kingofl337/afterglow_pico/pcb_v1.36c/render/Render.png

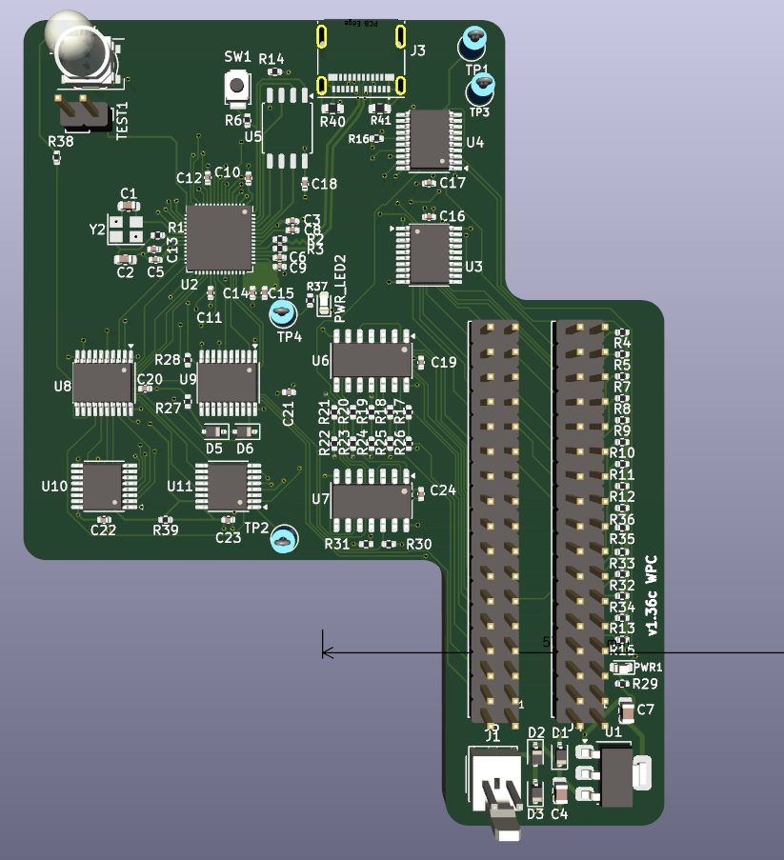
pcb_v1.36c/render/Render.png
