kingofl337/afterglow_pico/pcb_v1.36c/Afterglow Pico 1.36c.kicad_pcb

## KiCad design pcb_v1.36c/Afterglow Pico 1.36c.kicad_pcb (2025-01-01)

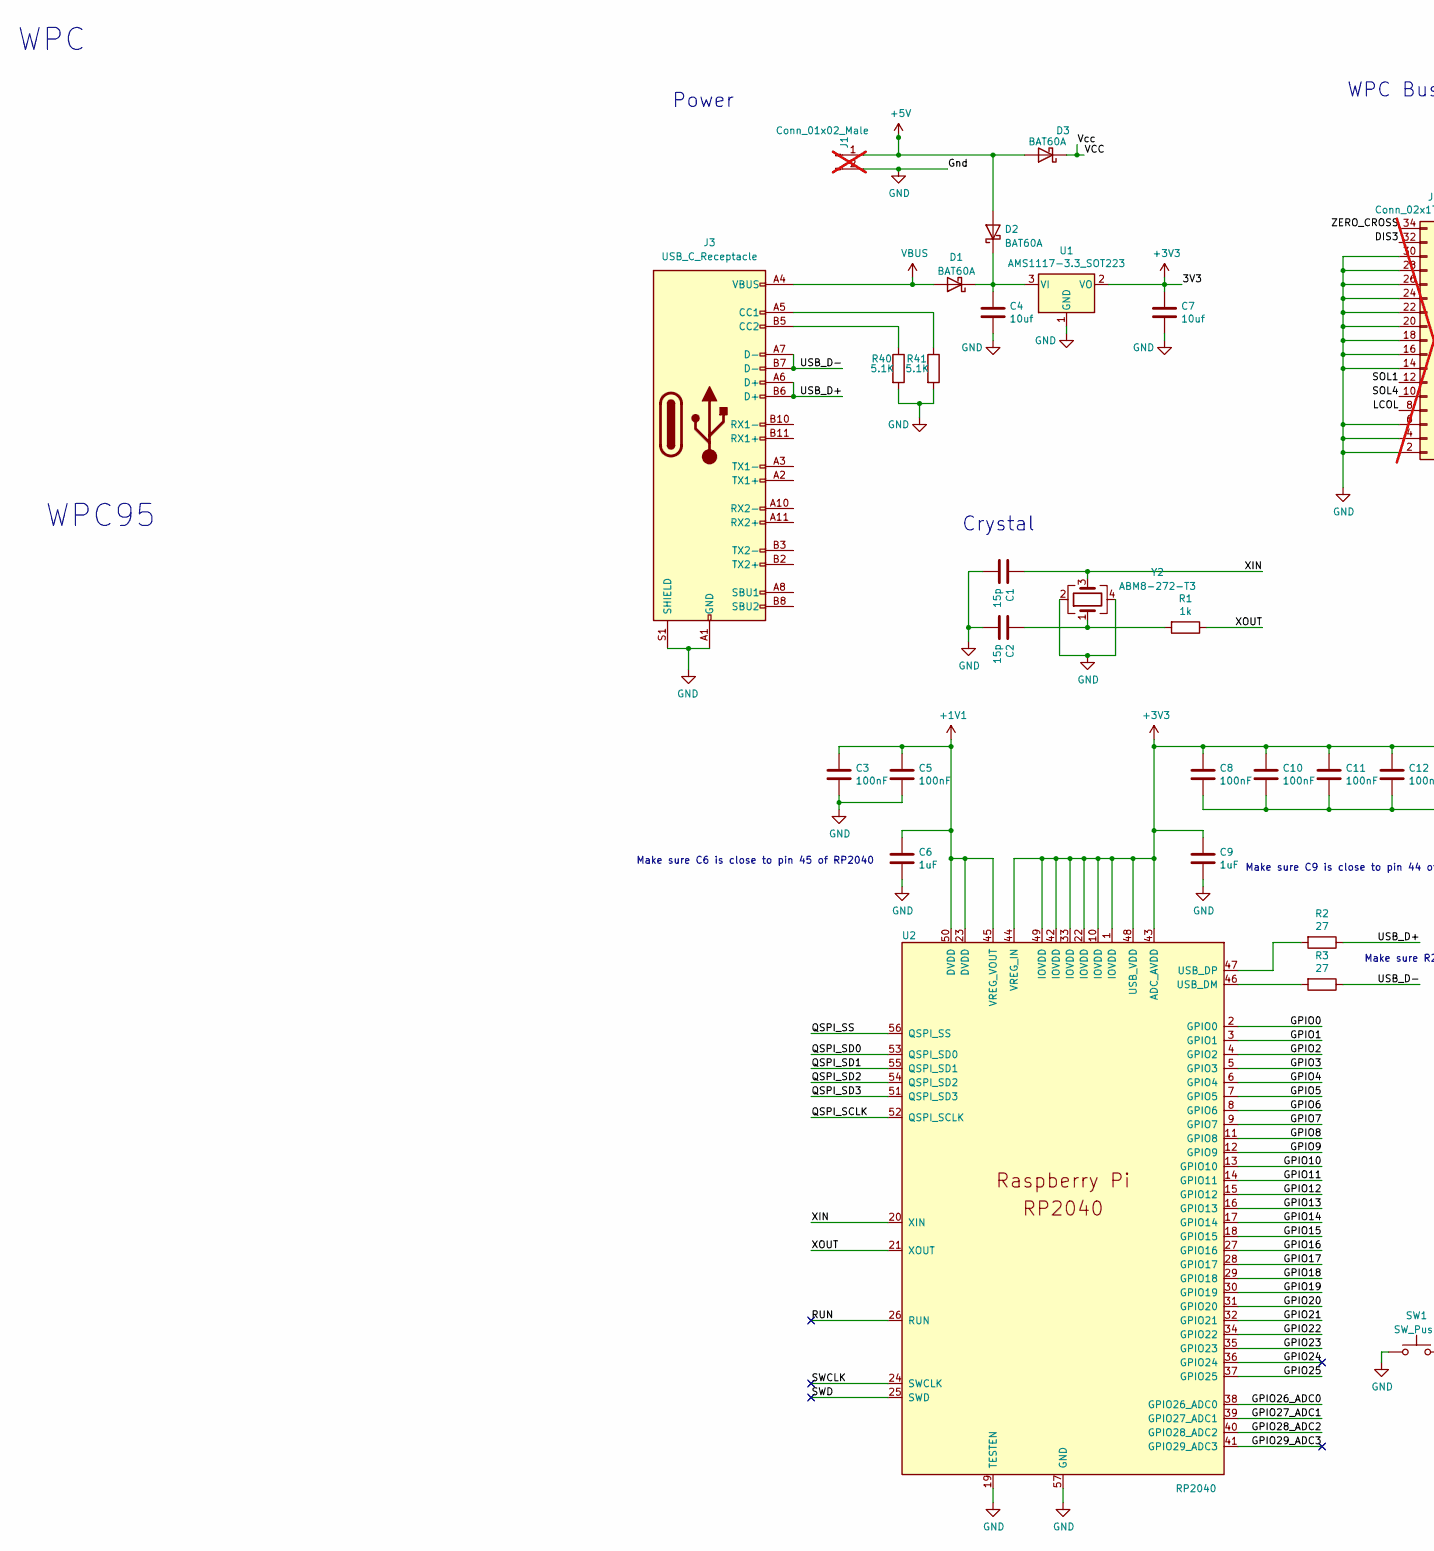
[picture p2: schematic Afterglow Pico 1.36c.kicad_sch, Afterglow Pico, part in row 1, column 1]

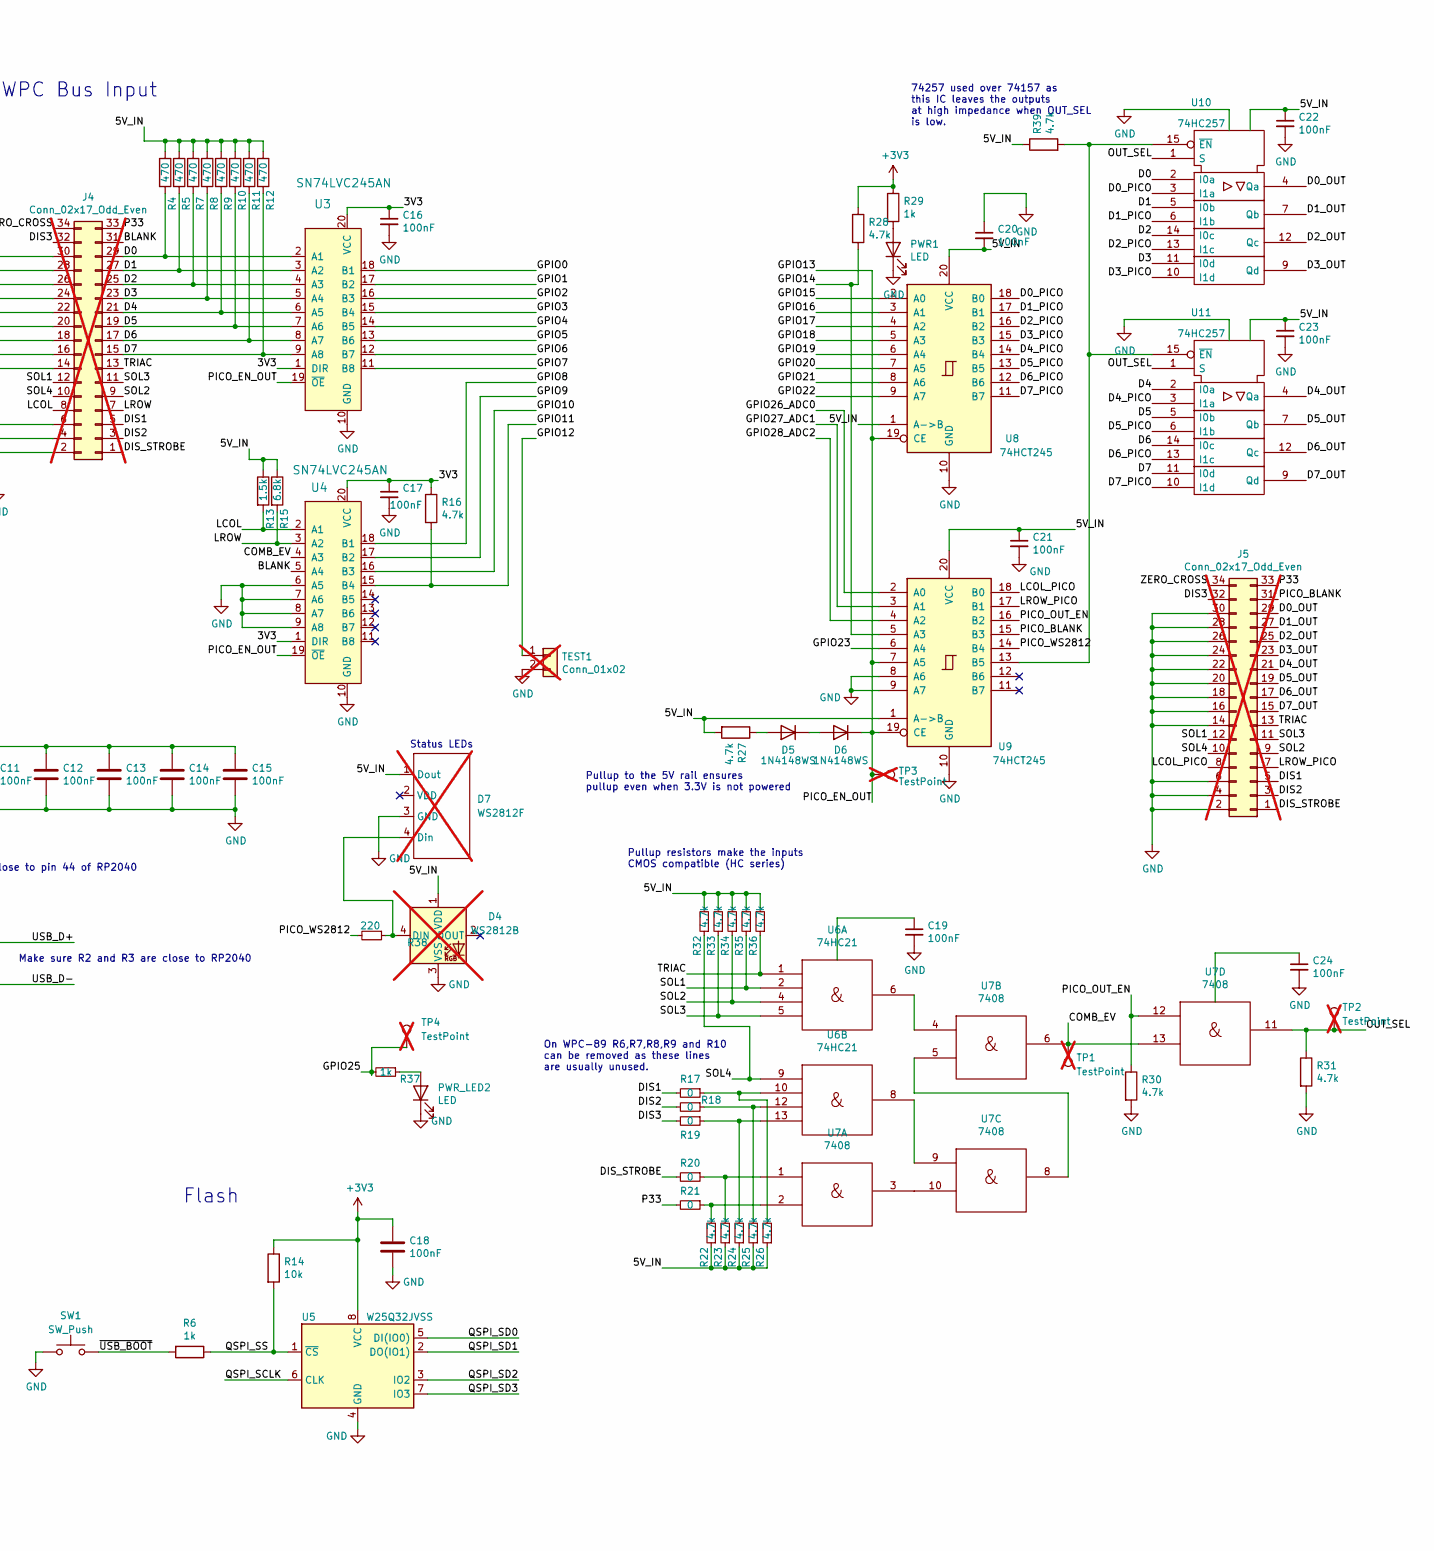
[picture p3: schematic Afterglow Pico 1.36c.kicad_sch, Afterglow Pico, part in row 1, column 2]

Parts:
C1, C2: 15p; C_0603_1608Metric; LCSC Part # C1644
C3, C5, C8, C10, C11, C12, C13, C14, C15, C16, C17, C18, C19, C20, C21, C22, C23, C24: 100nF; C_0402_1005Metric; LCSC Part # C307331
C4, C7: 10uf; C_0805_2012Metric; LCSC Part # C15850
C6, C9: 1uF; C_0402_1005Metric; LCSC Part # C52923
D1, D2, D3: BAT60A; D_SOD-323; LCSC Part # C513277
D4: WS2812B; LED_WS2812B_PLCC4_5.0x5.0mm_P3.2mm; LCSC Part # C2761795; not fitted
D5, D6: 1N4148WS; D_SOD-323; LCSC Part # C2128
D7: WS2812F; WS2812D-F5; not fitted
J1: Conn_01x02_Male; Molex_KK-254_AE-6410-02A_1x02_P2.54mm_Vertical; not fitted
J3: USB_C_Receptacle; USB_C_Receptacle_Molex_105450-0101; LCSC Part # C134092
J4: Conn_02x17_Odd_Even; PinHeader_2x17_P2.54mm_Vertical; not fitted
J5: Conn_02x17_Odd_Even; PinHeader_2x17_P2.54mm_Vertical; LCSC Part # C2894978; not fitted
PWR1: LED; LED_0603_1608Metric; LCSC Part # C2290
PWR_LED2: LED; LED_0603_1608Metric; LCSC Part # C2290
R1, R6, R29, R37: 1k; R_0402_1005Metric; LCSC Part # C11702
R2, R3: 27; R_0402_1005Metric; LCSC Part # C25100
R4, R5, R7, R8, R9, R10, R11, R12: 470; R_0402_1005Metric; LCSC Part # C25117
R13: 1.5k; R_0402_1005Metric; LCSC Part # C25867
R14: 10k; R_0402_1005Metric; LCSC Part # C25744
R15: 6.8k; R_0402_1005Metric; LCSC Part # C25917
R16, R22, R23, R24, R25, R26, R27, R28, R30, R31, R32, R33, R34, R35, R36, R39: 4.7k; R_0402_1005Metric; LCSC Part # C25900
R17, R18, R19, R20, R21: 0; R_0402_1005Metric; LCSC Part # C17168
R38: 220; R_0402_1005Metric; LCSC Part # C25091
R40, R41: 5.1K; R_0603_1608Metric; LCSC Part # C23186
SW1: SW_Push; SW_SPST_B3U-1000P; LCSC Part # C231329
TEST1: Conn_01x02; PinHeader_1x02_P2.54mm_Vertical; LCSC Part # C124375; not fitted
TP1, TP2, TP3, TP4: TestPoint; TestPoint_Loop_D1.80mm_Drill1.0mm_Beaded; not fitted
U1: AMS1117-3.3_SOT223; SOT-223-3_TabPin2; LCSC Part # C6186
U2: RP2040; RP2040-QFN-56; LCSC Part # C2040
U3, U4: SN74LVC245AN; TSSOP-20_4.4x6.5mm_P0.65mm; MPN SN74LVC245AN; Digi-Key_PN 296-8503-5-ND
U5: W25Q32JVSS; SOIC-8_5.23x5.23mm_P1.27mm; LCSC Part # C82344
U6: 74HC21; SOIC-14_3.9x8.7mm_P1.27mm; LCSC Part # C75398
U7: 7408; SOIC-14_3.9x8.7mm_P1.27mm; LCSC Part # C5593
U8, U9: 74HCT245; TSSOP-20_4.4x6.5mm_P0.65mm; LCSC Part # C6779
U10, U11: 74HC257; TSSOP-16_4.4x5mm_P0.65mm; LCSC Part # C2868824
Y2: ABM8-272-T3; Crystal_SMD_Abracon_ABM8AIG-4Pin_3.2x2.5mm; LCSC Part # C20625731

Connections:
+1V1: C3.1, C5.1, C6.1, U2.23 (DVDD), U2.45 (VREG_VOUT), U2.50 (DVDD)
+3V3: C7.1, C8.1, C9.1, C10.1, C11.1, C12.1, C13.1, C14.1, C15.1, C16.1, C17.1, C18.1, R14.1, R16.1, R28.1, R29.1, U1.2 (VO), U2.1 (IOVDD), U2.10 (IOVDD), U2.22 (IOVDD), U2.33 (IOVDD), U2.42 (IOVDD), U2.43 (ADC_AVDD), U2.44 (VREG_IN), U2.48 (USB_VDD), U2.49 (IOVDD), U3.1 (DIR), U3.20 (VCC), U4.1 (DIR), U4.20 (VCC), U5.8 (VCC)
+5V: D2.2 (A), D3.2 (A), J1.1
/BLANK: J4.31, U4.5 (A4)
/COMB_EV: TP1.1, U4.4 (A3), U7.6, U7.13
/D0: J4.29, R4.2, U3.2 (A1), U10.2 (I0a)
/D0_OUT: J5.29, U10.4 (Qa)
/D0_PICO: U8.18 (B0), U10.3 (I1a)
/D1: J4.27, R5.2, U3.3 (A2), U10.5 (I0b)
/D1_OUT: J5.27, U10.7 (Qb)
/D1_PICO: U8.17 (B1), U10.6 (I1b)
/D2: J4.25, R7.2, U3.4 (A3), U10.14 (I0c)
/D2_OUT: J5.25, U10.12 (Qc)
/D2_PICO: U8.16 (B2), U10.13 (I1c)
/D3: J4.23, R8.2, U3.5 (A4), U10.11 (I0d)
/D3_OUT: J5.23, U10.9 (Qd)
/D3_PICO: U8.15 (B3), U10.10 (I1d)
/D4: J4.21, R9.2, U3.6 (A5), U11.2 (I0a)
/D4_OUT: J5.21, U11.4 (Qa)
/D4_PICO: U8.14 (B4), U11.3 (I1a)
/D5: J4.19, R10.2, U3.7 (A6), U11.5 (I0b)
/D5_OUT: J5.19, U11.7 (Qb)
/D5_PICO: U8.13 (B5), U11.6 (I1b)
/D6: J4.17, R11.2, U3.8 (A7), U11.14 (I0c)
/D6_OUT: J5.17, U11.12 (Qc)
/D6_PICO: U8.12 (B6), U11.13 (I1c)
/D7: J4.15, R12.2, U3.9 (A8), U11.11 (I0d)
/D7_OUT: J5.15, U11.9 (Qd)
/D7_PICO: U8.11 (B7), U11.10 (I1d)
/DIS1: J4.5, J5.5, R17.2
/DIS2: J4.3, J5.3, R18.2
/DIS3: J4.32, J5.32, R19.2
/DIS_STROBE: J4.1, J5.1, R20.2
/GPIO0: U2.2 (GPIO0), U3.18 (B1)
/GPIO1: U2.3 (GPIO1), U3.17 (B2)
/GPIO2: U2.4 (GPIO2), U3.16 (B3)
/GPIO3: U2.5 (GPIO3), U3.15 (B4)
/GPIO4: U2.6 (GPIO4), U3.14 (B5)
/GPIO5: U2.7 (GPIO5), U3.13 (B6)
/GPIO6: U2.8 (GPIO6), U3.12 (B7)
/GPIO7: U2.9 (GPIO7), U3.11 (B8)
/GPIO8: U2.11 (GPIO8), U4.18 (B1)
/GPIO9: U2.12 (GPIO9), U4.17 (B2)
/GPIO10: U2.13 (GPIO10), U4.16 (B3)
/GPIO11: R16.2, U2.14 (GPIO11), U4.15 (B4)
/GPIO12: TEST1.1, U2.15 (GPIO12)
/GPIO13: D6.1 (K), TP3.1, U2.16 (GPIO13), U3.19 (~OE), U4.19 (~OE), U8.19 (CE), U9.7 (A5), U9.19 (CE)
/GPIO14: R28.2, U2.17 (GPIO14), U9.5 (A3)
/GPIO15: U2.18 (GPIO15), U8.2 (A0)
/GPIO16: U2.27 (GPIO16), U8.3 (A1)
/GPIO17: U2.28 (GPIO17), U8.4 (A2)
/GPIO18: U2.29 (GPIO18), U8.5 (A3)
/GPIO19: U2.30 (GPIO19), U8.6 (A4)
/GPIO20: U2.31 (GPIO20), U8.7 (A5)
/GPIO21: U2.32 (GPIO21), U8.8 (A6)
/GPIO22: U2.34 (GPIO22), U8.9 (A7)
/GPIO23: U2.35 (GPIO23), U9.6 (A4)
/GPIO24: U2.36 (GPIO24)
/GPIO25: R37.2, TP4.1, U2.37 (GPIO25)
/GPIO26_ADC0: U2.38 (GPIO26_ADC0), U9.2 (A0)
/GPIO27_ADC1: U2.39 (GPIO27_ADC1), U9.3 (A1)
/GPIO28_ADC2: U2.40 (GPIO28_ADC2), U9.4 (A2)
/GPIO29_ADC3: U2.41 (GPIO29_ADC3)
/LCOL: J4.8, R13.2, U4.2 (A1)
/LCOL_PICO: J5.8, U9.18 (B0)
/LROW: J4.7, R15.2, U4.3 (A2)
/LROW_PICO: J5.7, U9.17 (B1)
/OUT_SEL: R31.1, TP2.1, U7.11, U10.1 (S), U11.1 (S)
/P33: J4.33, J5.33, R21.2
/PICO_BLANK: J5.31, U9.15 (B3)
/PICO_OUT_EN: R30.1, U7.12, U9.16 (B2)
/PICO_WS2812: R38.2, U9.14 (B4)
/QSPI_SCLK: U2.52 (QSPI_SCLK), U5.6 (CLK)
/QSPI_SD0: U2.53 (QSPI_SD0), U5.5 (DI(IO0))
/QSPI_SD1: U2.55 (QSPI_SD1), U5.2 (DO(IO1))
/QSPI_SD2: U2.54 (QSPI_SD2), U5.3 (IO2)
/QSPI_SD3: U2.51 (QSPI_SD3), U5.7 (IO3)
/QSPI_SS: R6.1, R14.2, U2.56 (QSPI_SS), U5.1 (~CS)
/RUN: U2.26 (RUN)
/SOL1: J4.12, J5.12, R35.1, U6.2
/SOL2: J4.9, J5.9, R34.1, U6.4
/SOL3: J4.11, J5.11, R33.1, U6.5
/SOL4: J4.10, J5.10, R32.1, U6.9
/SWCLK: U2.24 (SWCLK)
/SWD: U2.25 (SWD)
/TRIAC: J4.13, J5.13, R36.1, U6.1
/USB_D+: J3.A6 (D+), J3.B6 (D+), R2.1
/USB_D-: J3.A7 (D-), J3.B7 (D-), R3.1
/XIN: C1.1, U2.20 (XIN), Y2.3
/XOUT: R1.1, U2.21 (XOUT)
/ZERO_CROSS: J4.34, J5.34
/~USB_BOOT: R6.2, SW1.2
GND: C1.2, C2.2, C3.2, C4.2, C5.2, C6.2, C7.2, C8.2, C9.2, C10.2, C11.2, C12.2, C13.2, C14.2, C15.2, C16.2, C17.2, C18.2, C19.2, C20.1, C21.2, C22.2, C23.2, C24.2, D4.3 (VSS), D7.3 (GND), J1.2, J3.A1 (GND), J3.A12 (GND), J3.B1 (GND), J3.B12 (GND), J3.S1 (SHIELD), J4.2, J4.4, J4.6, J4.14, J4.16, J4.18, J4.20, J4.22, J4.24, J4.26, J4.28, J4.30, J5.2, J5.4, J5.6, J5.14, J5.16, J5.18, J5.20, J5.22, J5.24, J5.26, J5.28, J5.30, PWR1.1 (K), PWR_LED2.1 (K), R30.2, R31.2, R40.2, R41.2, SW1.1, TEST1.2, U1.1 (GND), U2.19 (TESTEN), U2.57 (GND), U3.10 (GND), U4.6 (A5), U4.7 (A6), U4.8 (A7), U4.9 (A8), U4.10 (GND), U5.4 (GND), U6.7 (Gnd), U7.7 (Gnd), U8.10 (GND), U9.8 (A6), U9.9 (A7), U9.10 (GND), U10.8 (GND), U11.8 (GND), Y2.2, Y2.4
unnamed: C2.1, R1.2, Y2.1
unnamed: C4.1, D1.1 (K), D2.1 (K), U1.3 (VI)
unnamed: D4.4 (DIN), D7.4 (Din), R38.1
unnamed: D5.2 (A), R27.1
unnamed: D5.1 (K), D6.2 (A)
unnamed: J3.A5 (CC1), R41.1
unnamed: J3.B5 (CC2), R40.1
unnamed: PWR1.2 (A), R29.2
unnamed: PWR_LED2.2 (A), R37.1
unnamed: R17.1, R26.2, U6.10
unnamed: R18.1, R25.2, U6.12
unnamed: R19.1, R24.2, U6.13
unnamed: R20.1, R23.2, U7.1
unnamed: R21.1, R22.2, U7.2
unnamed: R3.2, U2.46 (USB_DM)
unnamed: R2.2, U2.47 (USB_DP)
unnamed: U6.6, U7.4
unnamed: U6.8, U7.9
unnamed: U7.5, U7.8
unnamed: U7.3, U7.10
unnamed: R39.2, U9.13 (B5), U10.15 (~EN), U11.15 (~EN)
VBUS: D1.2 (A), J3.A4 (VBUS), J3.A9 (VBUS), J3.B4 (VBUS), J3.B9 (VBUS)

Notes on the sheet:
WPC
Pullup to the 5V rail ensures pullup even when 3.3V is not powered
Status LEDs
Pullup resistors make the inputs CMOS compatible (HC series)
Make sure C9 is close to pin 44 of RP2040
Power
Crystal
74257 used over 74157 as this IC leaves the outputs at high impedance when OUT_SEL is low.
On WPC-89 R6,R7,R8,R9 and R10 can be removed as these lines are usually unused.
WPC Bus Input
WPC95
Make sure R2 and R3 are close to RP2040
Flash
Make sure C6 is close to pin 45 of RP2040

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
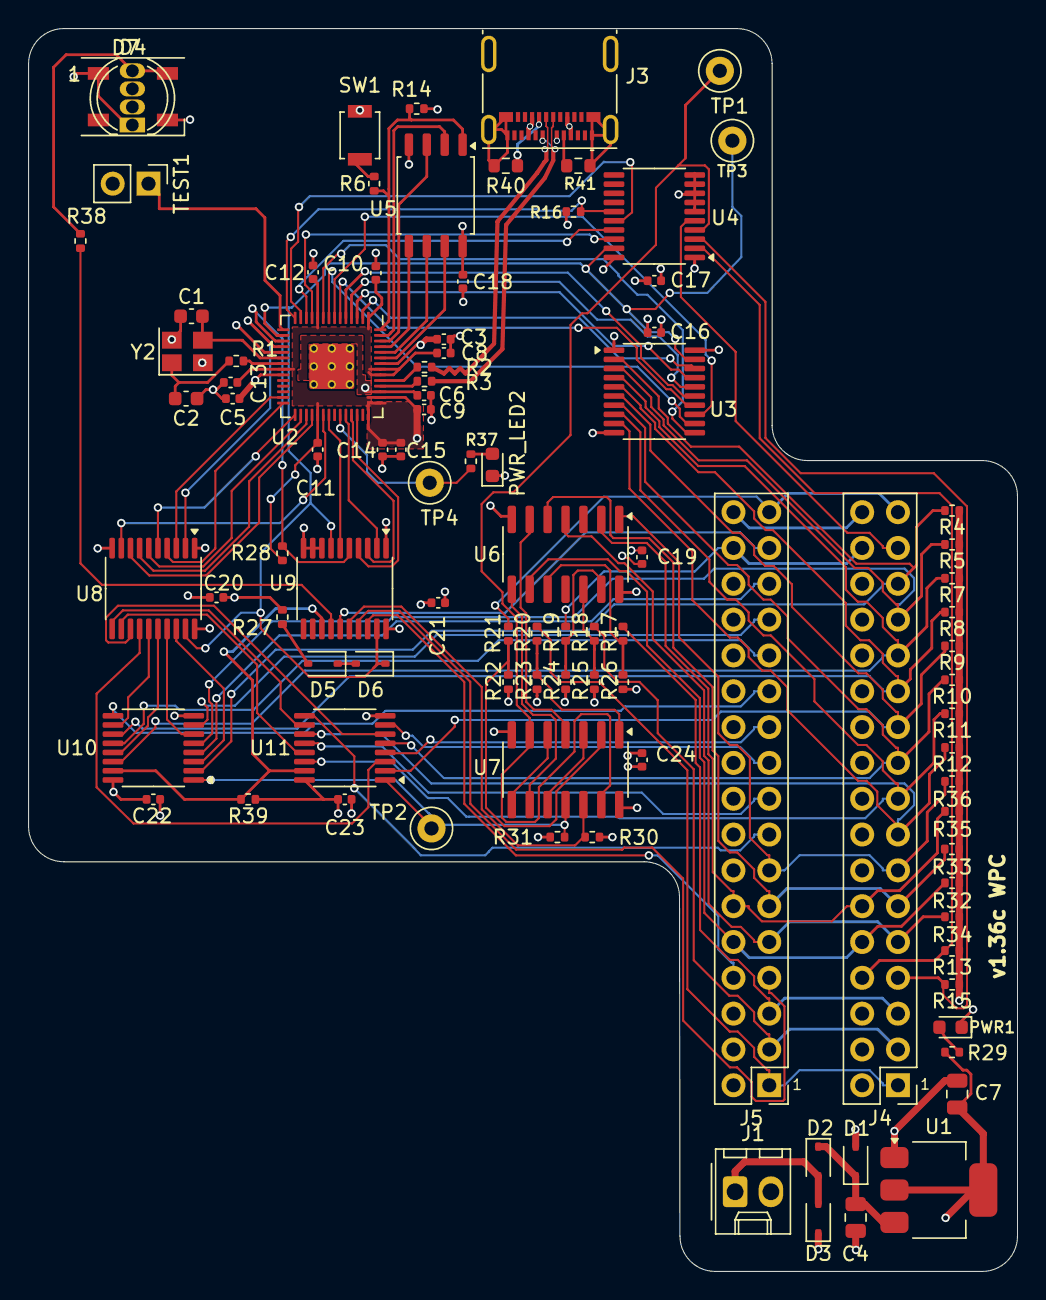
[picture p4: board Afterglow Pico 1.36c.kicad_pcb from above]

Board: 4 copper layers, 70.1 x 88.1 mm, 96 parts (0 on the bottom side), 111 nets.
